Sxul-RL/CarWithArtificialVision/Screenshot_20181022-211512.png

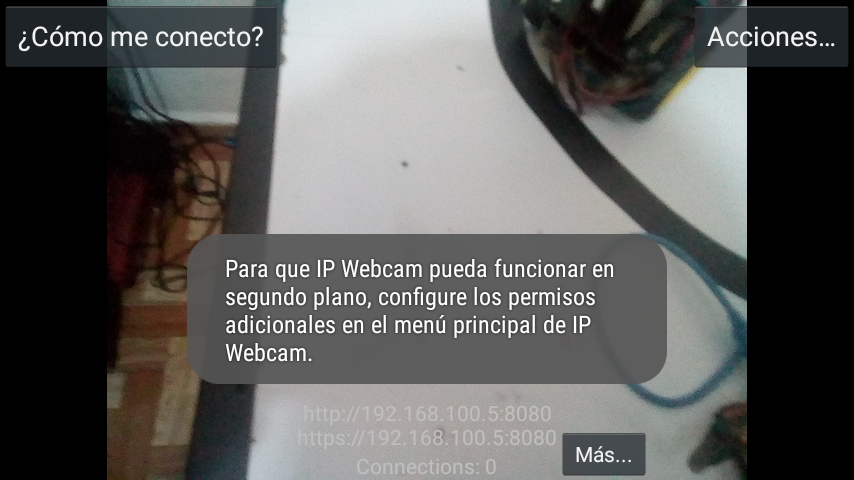
Screenshot_20181022-211512.png
