Sxul-RL/CarWithArtificialVision/IMG_20180916_155143.jpg

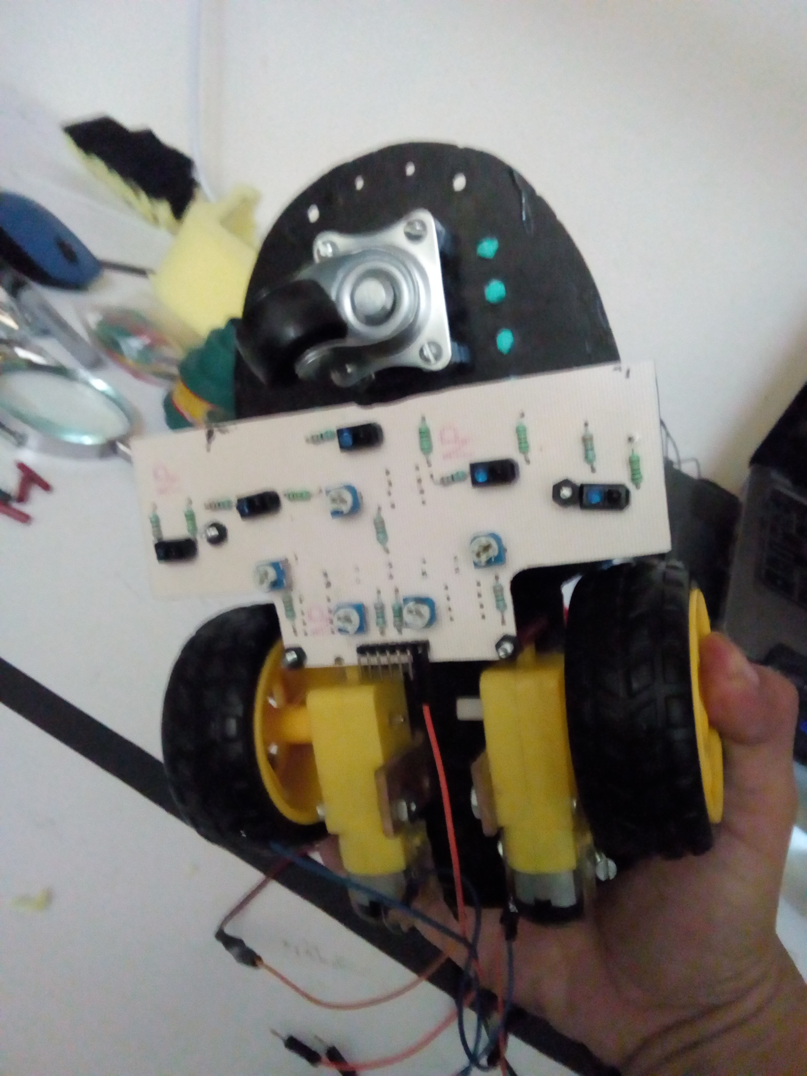
IMG_20180916_155143.jpg
