Sxul-RL/CarWithArtificialVision/README.md

# CarWithArtificialVision
El proposito de la creacion de este proyecto es el siguiente: -Crear un sistema robótico sigue-líneas usando sensores IR que envíen las señales a una placa de desarrollo que conducirá al sistema con un control PID. -Diseñar una interfaz GUI en Qt que controle al sistema robótico en función autónoma y manual y haga uso de visión artificial en tiempo real para la detección de objetos como señales de tráfico y semáforos. Además, incorporar un sistema de comunicación por RF con otra placa de desarrollo que se enlace al robot y ejerza las funciones manuales o autónomas. -Detener el sistema robótico en control automático o control manual cada que un objeto se encuentre enfrente de él.
