Sxul-RL/CarWithArtificialVision/Ejemplo11-QT-CambiarIPCamara/imagenes/Cucei.jpg

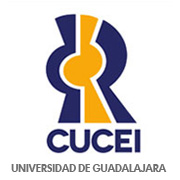
Ejemplo11-QT-CambiarIPCamara/imagenes/Cucei.jpg
