Sxul-RL/CarWithArtificialVision/Ejemplo11-QT-CambiarIPCamara/imagenes/udg-02.jpg

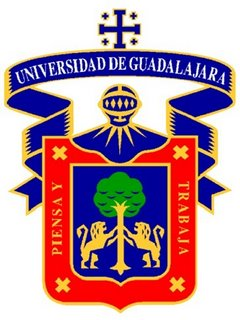
Ejemplo11-QT-CambiarIPCamara/imagenes/udg-02.jpg
