Sxul-RL/CarWithArtificialVision/IMG_20180515_165340.jpg

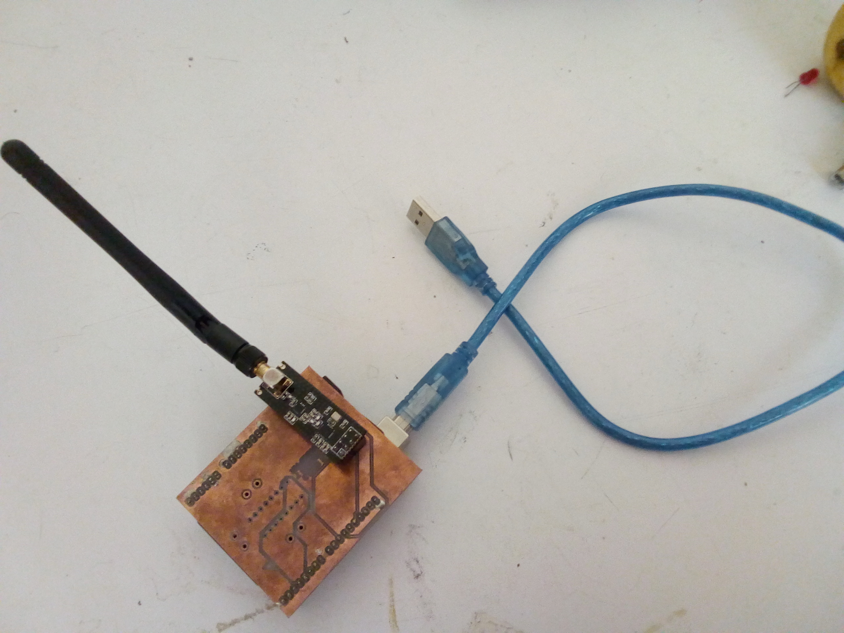
IMG_20180515_165340.jpg
