Sxul-RL/CarWithArtificialVision/IMG_20181025_083945.jpg

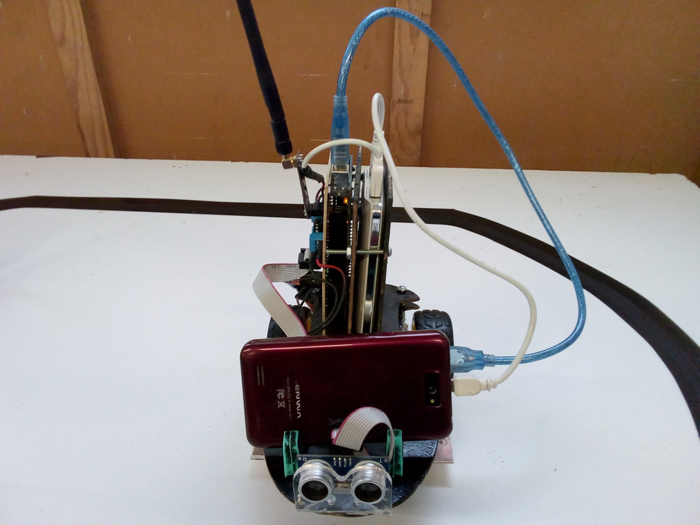
IMG_20181025_083945.jpg
